Horizon-Avionics/Horizon-Mini/Software/src/sensors/ERRORCODES.md

ERROR 1 = Failed IMU i2c initialization
ERROR 2 = Faile IMU Reading
Error 3 = Failed BMU i2c initialization
Error 4 = Failed BMU reading
