Horizon-Avionics/Horizon-Mini/BOM.md

## PCB Components
| Name | Part # | Qty | Total Price |
| --- | --- | --- | --- |
| Buzzer | QMB-09B-03 | 3 | 0.3276 |
| 100nF | CC0603KRX7R9BB104 | 40 | 0.092 |
| 100nF |  |  |  |
| 100nF | CL05B104KO5NNNC | 22 | 0.0242 |
| 3.3nF | CL10B332KB8NNNC | 20 | 0.102 |
| 10uF | CL10A106KP8NNNC | 40 | 0.224 |
| 10uF |  |  |  |
| 4n7 | 0603B472K500NT | 20 | 0.054 |
| 22uF | CL10A226MQ8NRNC | 20 | 0.172 |
| 1uF | CL10A105KB8NNNC | 20 | 0.094 |
| 1uF |  |  |  |
| 2u2 | CL10A225KO8NNNC | 20 | 0.114 |
| 100u | CL31A107MQHNNNE | 6 | 0.3924 |
| SMLVN6RGB | SMLVN6RGB1U1 | 2 | 1.614 |
| PMEG6020ER | PMEG6020ER | 16 | 0.6752 |
| LED | KT-0603R | 20 | 0.112 |
| PRTR5V0U2X | PRTR5V0U2X | 6 | 0.237 |
| Conn_01x02_Pin | DB301V-3.5-2P-GN-S | 3 | 0.2706 |
| Micro_SD_Card_Det1 | DM3D-SF | 2 | 2.028 |
| USB_C_Receptacle_USB2.0_16P | GT-USB-7010ASV | 2. | 0.1572 |
| Conn_02x03_Counter_Clockwise | ZX-PZ2.54-2-3PZZ | 2 | 0.0624 |
| SLF7055T-6R8N2R8-3PF | SLF7055T-6R8N2R8-3PF | 2 | 0.5478 |
| BSS138 | BSS138 | 10.| 0.162 |
| DMG2301L | DMG2301L | 6 | 0.3378 |
| 2k2 | 0603WAF2201T5E | 40 | 0.04 |
| 2.2k |  |  |  |
| 10kΩ | 0402WGF1002TCE | 20 | 0.01 |
| 350k | AR03FTDX3503N | 20 | 0.156 |
| 100 | 0603WAF1000T5E | 20 | 0.02 |
| 430k | 0603WAF4303T5E | 20 | 0.022 |
| 100k | 0603WAF1003T5E | 40 | 0.04 |
| 10kΩ | 0603WAF1002T5E | 40 | 0.036 |
| 10k |  |  |  |
| 220 | 0603WAF2200T5E | 20 | 0.022 |
| 330 | 0603WAF3300T5E | 20 | 0.02 |
| 5k1 | 0603WAF5101T5E | 20 | 0.02 |
| 1.5k | 0603WAF1501T5E | 20 | 0.02 |
| TPS82130 | TPS82130SILR | 2 | 2.541 |
| TPS61092 | TPS61092RSAR | 2 | 4.731 |
| LTC4412xS6 | LTC4412IS6#TRMPBF | 2 | 5.496 |
| ATSAMD21G18A-A | ATSAMD21G18A-AU | 2 | 6.2 |
| NAND | W25Q128JVSIQ | 2 | 1.821 |
| LSM6DS3 | LSM6DS3TR-C | 2 | 2.091 |
| AP2112K-3.3 | AP2112K-3.3TRG1 | 5 | 0.4615 |
| LPS22HB | LPS22HBTR | 2 | 0.8505 |

---

## Extra Parts
| Comment | Part # | Qty | Total Price |
| --- | --- | --- | --- |
| LPS22HB | AliExpress | 2 | 4 |
| DAPLINK | AliExpress | 2 | 4 |
| Hot Air Gun | https://www.amazon.ca/TXINLEI-8858-Station-Soldering-Nozzles/dp/B09VXD8BTF | 1 | 35.44 |

---

## Totals
- **PCB total (with tax & shipping):** 41.06
- **LCSC Parts total (with tax & shipping):** 52.14
- **Other Items(with tax & shipping):** 43.44
- **Grand total:** $136.64
