Horizon-Avionics/Horizon-Mini/Hardware/.step

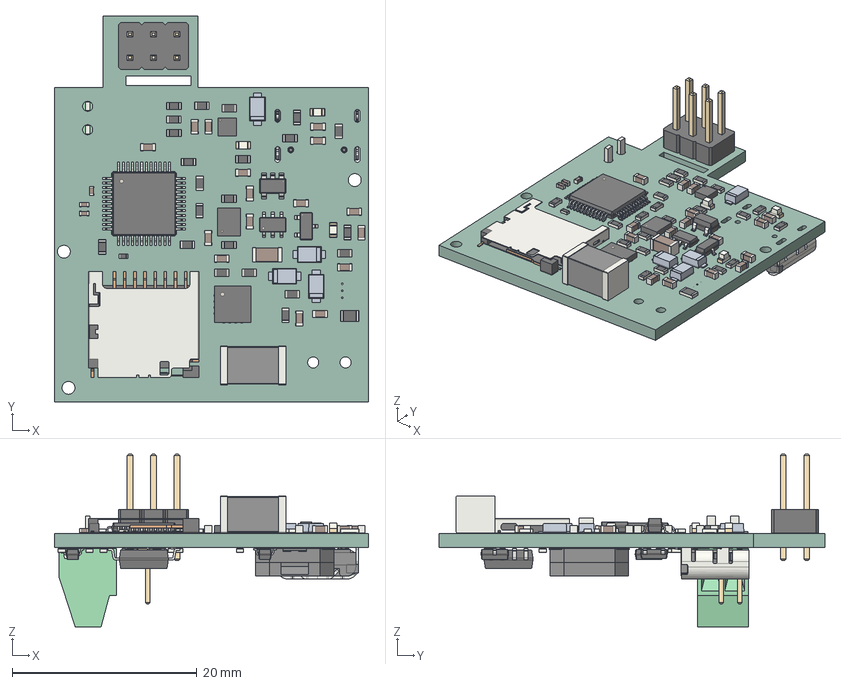
[picture p6: CAD file, 2025-12-22]
Hardware/.step
34.0 x 41.8 x 18.7 mm
R_0603_1608Metric x 30
SOT-23 x 3
C_0603_1608Metric x 16
.step 1.8.1 x 4
LED_0603_1608Metric x 4
TQFP-48_7x7mm_P0.5mm
PinHeader_2x03_P2.54mm_Vertical
microSD_HC_Hirose_DM3D-SF
SOT-23-5
R_0402_1005Metric
C_1206_3216Metric
L_2816_7142Metric
C_0402_1005Metric x 6
LGA-14_3x2.5mm_P0.5mm_LayoutBorder3x4y
ST_HLGA-10_2x2mm_P0.5mm_LayoutBorder3x2y
TSOT-23-6
Texas_RSA_VQFN-16-1EP_4x4mm_P0.65mm_EP2.7x2.7mm
R_0805_2012Metric
PinHeader_1x02_P2.00mm_Vertical_SMD_Pin1Left
TerminalBlock_Phoenix_MPT-0,5-2-2.54_1x02_P2.54mm_Horizontal
SOT-143
USB_C_Receptacle_GCT_USB4105-xx-A_16P_TopMnt_Horizontal
MLT-8530--3DModel-STEP-269445
Fuse_0603_1608Metric
SOIC-8_5.3x5.3mm_P1.27mm
horizon-mini_PCB
