Horizon-Avionics/Horizon-Mini/Hardware/horizon-mini.kicad_pcb

## KiCad design Hardware/horizon-mini.kicad_pcb (2026-02-26)

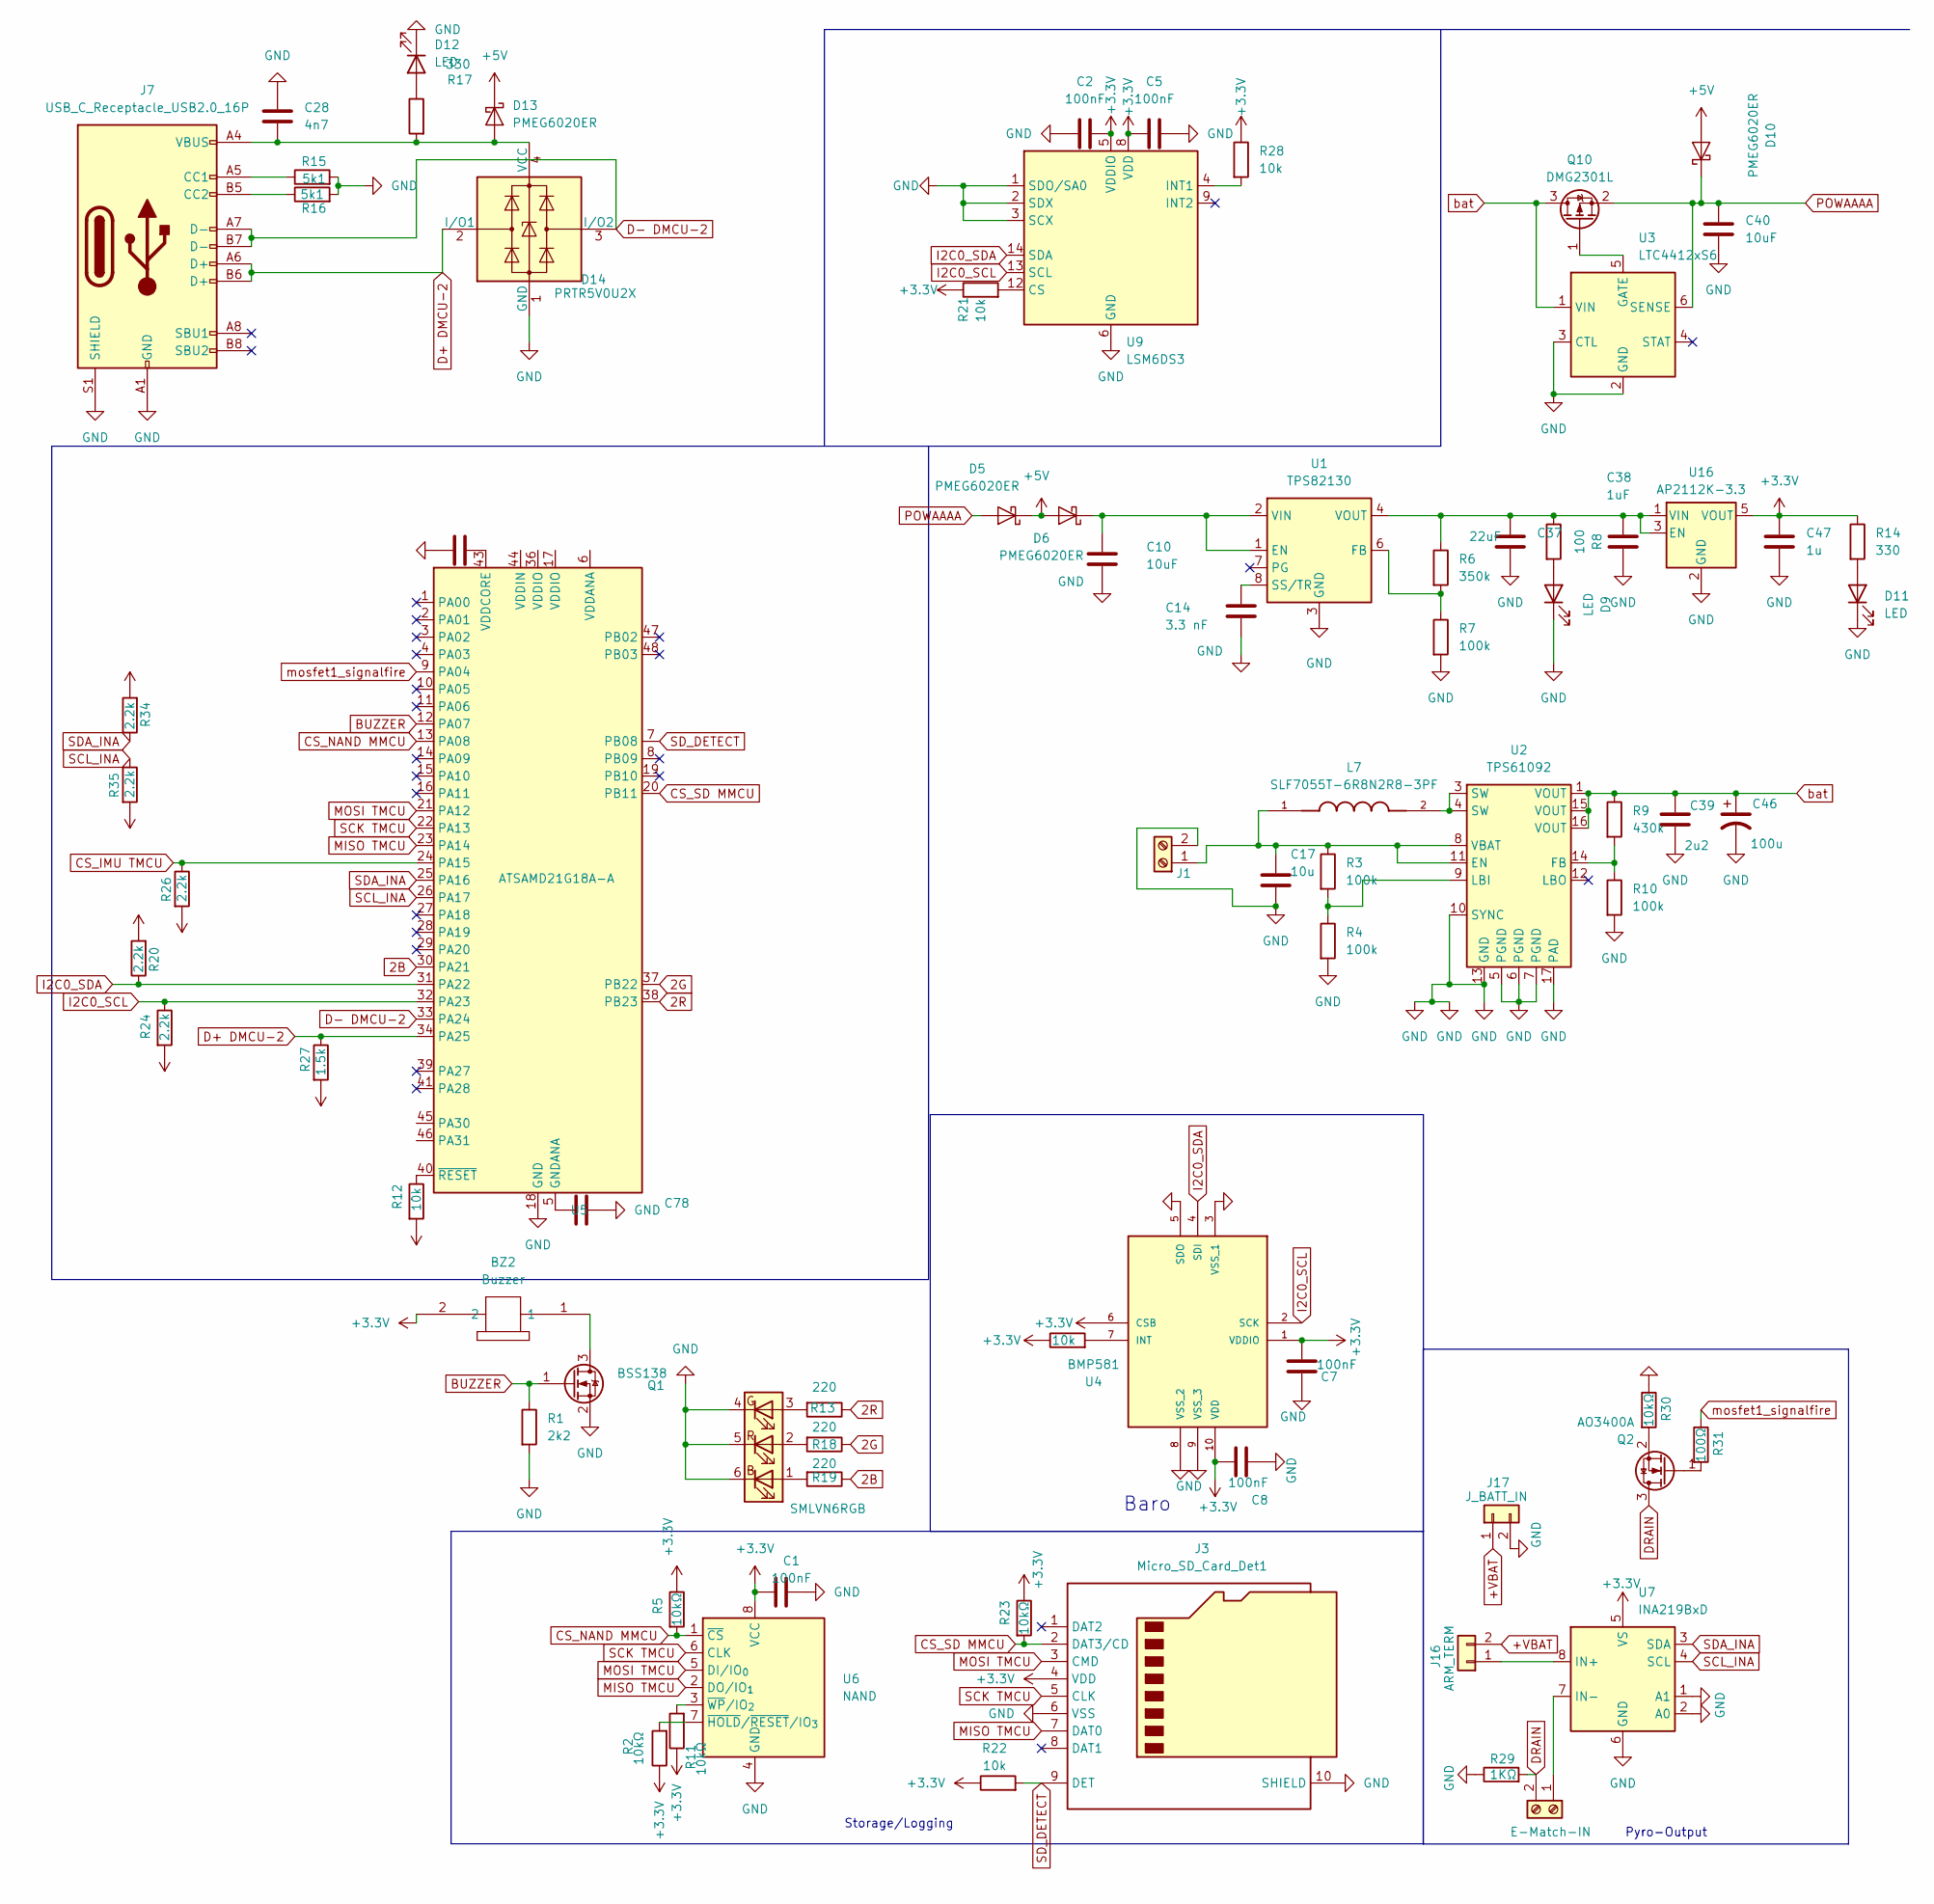
[picture p7: schematic horizon-mini.kicad_sch]

Parts:
BZ2: Buzzer; MLT-8530_JHE
C1, C2, C5, C7, C8, C78: 100nF; C_0402_1005Metric
C6: F1uF; C_0402_1005Metric
C10, C40: 10uF; C_0402_1005Metric
C14: 3.3 nF; C_0402_1005Metric
C17: 10u; C_0402_1005Metric
C28: 4n7; C_0402_1005Metric
C37: 22uF; C_0402_1005Metric
C38: 1uF; C_0402_1005Metric
C39: 2u2; C_0402_1005Metric
C46: 100u; C_0402_1005Metric
C47: 1u; C_0402_1005Metric
D1: SMLVN6RGB; LED_ROHM_SMLVN6
D5, D6, D10, D13: PMEG6020ER; Nexperia_CFP3_SOD-123W
D9, D11, D12: LED; LED_0603_1608Metric
D14: PRTR5V0U2X; SOT-143
J1: Screw_Terminal_01x02; TerminalBlock_Phoenix_MPT-0,5-2-2.54_1x02_P2.54mm_Horizontal
J3: Micro_SD_Card_Det1; microSD_HC_Hirose_DM3D-SF
J4: E-Match-IN; TerminalBlock_Phoenix_MPT-0,5-2-2.54_1x02_P2.54mm_Horizontal
J7: USB_C_Receptacle_USB2.0_16P; USB_C_Receptacle_GCT_USB4105-xx-A_16P_TopMnt_Horizontal
J16: ARM_TERM; PinHeader_1x02_P1.27mm_Vertical
J17: J_BATT_IN; PinHeader_1x02_P1.27mm_Vertical
L7: SLF7055T-6R8N2R8-3PF; L_7.3x7.3_H4.5; PARTREV N/A
Q1: BSS138; SOT-23
Q2: AO3400A; SOT-23
Q10: DMG2301L; SOT-23
R1: 2k2; R_0402_1005Metric
R2, R5, R11, R23, R30: 10kΩ; R_0402_1005Metric
R3, R4, R7, R10: 100k; R_0402_1005Metric
R6: 350k; R_0402_1005Metric
R8: 100; R_0402_1005Metric
R9: 430k; R_0402_1005Metric
R12, R21, R22, R28, R33: 10k; R_0402_1005Metric
R13, R18, R19: 220; R_0402_1005Metric
R14, R17: 330; R_0402_1005Metric
R15, R16: 5k1; R_0402_1005Metric
R20, R24, R26, R34, R35: 2.2k; R_0402_1005Metric
R27: 1.5k; R_0402_1005Metric
R29: 1KΩ; R_0402_1005Metric
R31: 100Ω; R_0402_1005Metric
U1: TPS82130; Texas_SIL0008D_MicroSiP-8-1EP_2.8x3mm_P0.65mm_EP1.1x1.9mm_T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
U2: TPS61092; Texas_RSA_VQFN-16-1EP_4x4mm_P0.65mm_EP2.7x2.7mm_ThermalVias
U3: LTC4412xS6; TSOT-23-6
U4: BMP581; Manufacturer_Part_Number BMP581
U5: ATSAMD21G18A-A; TQFP-48_7x7mm_P0.5mm
U6: NAND; SOIC-8_5.3x5.3mm_P1.27mm
U7: INA219BxD; SOIC-8_3.9x4.9mm_P1.27mm
U9: LSM6DS3; LGA-14_3x2.5mm_P0.5mm_LayoutBorder3x4y
U16: AP2112K-3.3; SOT-23-5

Connections:
2B: R19.1, U5.30 (PA21)
2G: R18.1, U5.37 (PB22)
2R: R13.1, U5.38 (PB23)
+3.3V: BZ2.2, C1.1, C2.2, C5.2, C7.2, C8.2, C47.1, J3.4 (VDD), R2.1, R5.1, R11.1, R12.2, R14.1, R20.2, R21.1, R22.1, R23.1, R24.2, R26.2, R27.2, R28.1, R33.1, R34.2, R35.2, U4.1 (VDDIO), U4.6 (CSB), U4.10 (VDD), U6.8 (VCC), U7.5 (VS), U9.5 (VDDIO), U9.8 (VDD), U16.5 (VOUT)
+5V: D5.1 (K), D6.2 (A), D10.2 (A), D13.1 (K)
+VBAT: J16.2, J17.1
BUZZER: Q1.1 (G), R1.1, U5.12 (PA07)
CS_IMU TMCU: R26.1, U5.24 (PA15)
CS_NAND MMCU: R5.2, U5.13 (PA08), U6.1 (~CS)
CS_SD MMCU: J3.2 (DAT3/CD), R23.2, U5.20 (PB11)
D+ DMCU-2: D14.2 (I/O1), J7.A6 (D+), J7.B6 (D+), R27.1, U5.34 (PA25)
D- DMCU-2: D14.3 (I/O2), J7.A7 (D-), J7.B7 (D-), U5.33 (PA24)
DRAIN: J4.2, Q2.3 (D), R29.2
GND: C1.2, C2.1, C5.1, C6.2, C7.1, C8.1, C10.2, C14.2, C17.2, C28.1, C37.2, C38.2, C39.2, C40.2, C46.2, C47.2, C78.1, D1.4 (GK), D1.5 (RK), D1.6 (BK), D9.1 (K), D11.1 (K), D12.1 (K), D14.1 (GND), J1.2, J3.6 (VSS), J3.10 (SHIELD), J7.A1 (GND), J7.A12 (GND), J7.B1 (GND), J7.B12 (GND), J7.S1 (SHIELD), J17.2, Q1.2 (S), R1.2, R4.2, R7.2, R10.2, R15.2, R16.2, R29.1, R30.1, U1.3 (GND), U1.9 (GND), U2.5 (PGND), U2.6 (PGND), U2.7 (PGND), U2.10 (SYNC), U2.13 (GND), U2.17 (PAD), U3.2 (GND), U3.3 (CTL), U4.3 (VSS_1), U4.5 (SDO), U4.8 (VSS_2), U4.9 (VSS_3), U5.18 (GND), U5.35 (GND), U5.42 (GND), U6.4 (GND), U7.1 (A1), U7.2 (A0), U7.6 (GND), U9.1 (SDO/SA0), U9.2 (SDX), U9.3 (SCX), U9.6 (GND), U9.7 (GND), U16.2 (GND); also elsewhere on the board
I2C0_SCL: R24.1, U4.2 (SCK), U5.32 (PA23), U9.13 (SCL)
I2C0_SDA: R20.1, U4.4 (SDI), U5.31 (PA22), U9.14 (SDA)
MISO TMCU: J3.7 (DAT0), U5.23 (PA14), U6.2 (DO/IO_{1})
MOSI TMCU: J3.3 (CMD), U5.21 (PA12), U6.5 (DI/IO_{0})
unnamed: D1.1 (BA), R19.2
unnamed: D1.3 (GA), R13.2
unnamed: D1.2 (RA), R18.2
unnamed: C10.1, D6.1 (K), U1.1 (EN), U1.2 (VIN)
unnamed: D9.2 (A), R8.2
unnamed: D11.2 (A), R14.2
unnamed: D12.2 (A), R17.1
unnamed 25: C28.2, D13.2 (A), D14.4 (VCC), J7.A4 (VBUS), J7.A9 (VBUS), J7.B4 (VBUS), J7.B9 (VBUS), R17.2; also elsewhere on the board
unnamed: C17.1, J1.1, L7.1, R3.1, U2.8 (VBAT), U2.11 (EN)
unnamed: J4.1, U7.7 (IN-)
unnamed: J7.A5 (CC1), R15.1
unnamed: J7.B5 (CC2), R16.1
unnamed: J16.1, U7.8 (IN+)
unnamed: L7.2, U2.3 (SW), U2.4 (SW)
unnamed: BZ2.1, Q1.3 (D)
unnamed: Q2.1 (G), R31.2
unnamed: Q2.2 (S), R30.2
unnamed: Q10.1 (G), U3.5 (GATE)
unnamed: R6.2, R7.1, U1.6 (FB)
unnamed: C14.1, U1.8 (SS/TR)
unnamed: R9.2, R10.1, U2.14 (FB)
unnamed: R3.2, R4.1, U2.9 (LBI)
unnamed: R33.2, U4.7 (INT)
unnamed: C78.2, U5.5 (GNDANA)
unnamed: C6.1, U5.43 (VDDCORE)
unnamed: R12.1, U5.40 (~RESET)
unnamed: R2.2, U6.7 (~HOLD/~RESET/IO_{3})
unnamed: R11.2, U6.3 (~WP/IO_{2})
unnamed: R21.2, U9.12 (CS)
unnamed: R28.2, U9.4 (INT1)
unnamed: C37.1, C38.1, R6.1, R8.1, U1.4 (VOUT), U1.5 (VOUT), U16.1 (VIN), U16.3 (EN)
POWAAAA: C40.1, D5.2 (A), D10.1 (K), Q10.2 (S), U3.6 (SENSE)
SCK TMCU: J3.5 (CLK), U5.22 (PA13), U6.6 (CLK)
SCL_INA: R35.1, U5.26 (PA17)
SDA_INA: R34.1, U5.25 (PA16)
SD_DETECT: J3.9 (DET), R22.2, U5.7 (PB08)
bat: C39.1, C46.1, Q10.3 (D), R9.1, U2.1 (VOUT), U2.15 (VOUT), U2.16 (VOUT), U3.1 (VIN)
mosfet1_signalfire: R31.1, U5.9 (PA04)

Notes on the sheet:
Pyro-Output
Storage/Logging
Baro

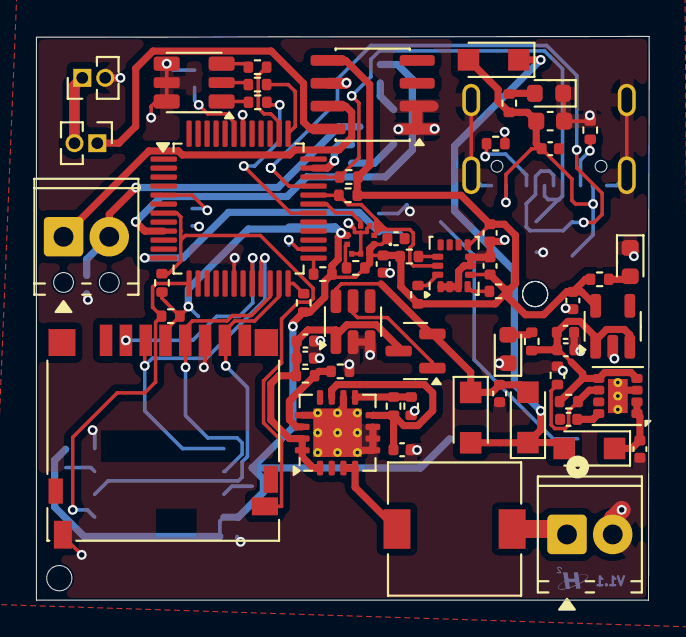
[picture p8: board horizon-mini.kicad_pcb from above]

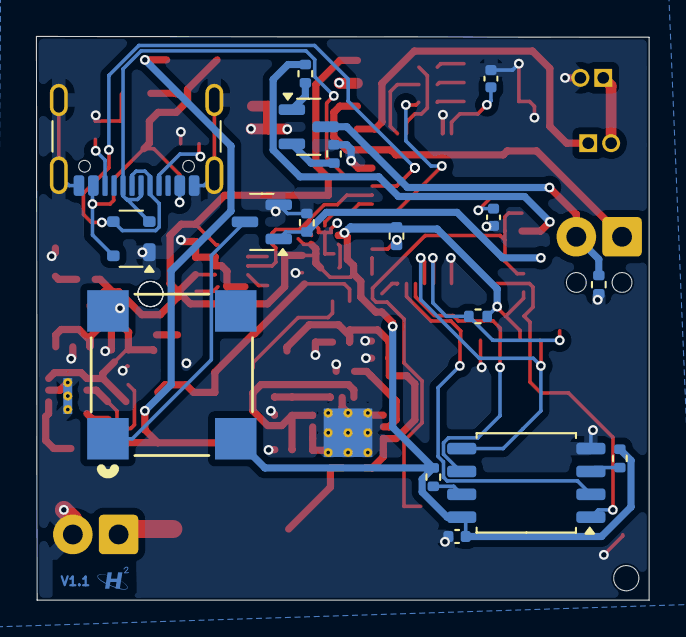
[picture p9: board horizon-mini.kicad_pcb from below]

Board: 2 copper layers, 34.0 x 31.3 mm, 79 parts (17 on the bottom side), 55 nets.

Other parts of the board:
C29: 100n; C_0603_1608Metric

Their connections:
GND: C29.1; also elsewhere on the board
unnamed 25: C29.2; also elsewhere on the board
