Horizon-Avionics/Horizon-Mini/(commit log)

2025-06-29 added kicad project
    [horizon-mini.kicad_pcb, horizon-mini.kicad_sch]
2025-06-29 added main board files
    [horizon.kicad_pcb, horizon.kicad_sch, power.kicad_sch, sensor.kicad_sch, usb.kicad_sch]
2025-06-29 Deleted unneeded chips and changes sensors from spi to i2c
    [horizon-mini.kicad_pcb, horizon.kicad_pcb, horizon.kicad_sch, power.kicad_sch, sensor.kicad_sch, usb.kicad_sch]
2025-06-29 moved files to folders
    [horizon-mini.kicad_pcb, horizon-mini.kicad_sch, horizon.kicad_sch]
2025-06-29 deleted unneeded files
    [horizon-mini.kicad_sch, horizon.kicad_pcb, horizon.kicad_sch, power.kicad_sch, sensor.kicad_sch, usb.kicad_sch]
2025-06-29 deleted MORE files
    [horizon-mini.kicad_sch]
2025-06-30 starting first routing
    [horizon-mini.kicad_pcb]
2025-06-30 idk more changes
    [horizon-mini.kicad_sch]
2025-06-30 traces v1
2025-06-30 routes v2!!!!
    [horizon-mini.kicad_pcb]
2025-07-08 finish v2 traces
    [horizon-mini.kicad_pcb, horizon-mini.kicad_sch]
2025-07-08 Re-started routing, like 3/4 done parts placement
    [horizon-mini.kicad_pcb, horizon-mini.kicad_sch]
2025-07-08 parts placement is done
    [horizon-mini.kicad_pcb, horizon-mini.kicad_sch]
2025-07-08 board routing is finally done... DRC errors look fake to me, but need to be double checked
2025-07-09 uuuh, fixed shematic and re-did most of the routing for the new MCU :(
    [horizon-mini.kicad_pcb, horizon-mini.kicad_sch]
2025-07-09 Revert "Merge branch 'main' of https://github.com/Horizon-Avionics/Horizon-Mini"
    This reverts commit 9a022c3cd95984122db224f561db0d5bee869fb2, reversing
    changes made to 44f91161868ebb609577ad71ea77d3c9bc8dd4bf.
    [horizon-mini.kicad_sch]
2025-07-09 Wiring take 2 is done- just a few DRC errors left
    [horizon-mini.kicad_pcb, horizon-mini.kicad_sch]
2025-07-09 deleted unneded files and added software folder
    [horizon-mini.kicad_pcb, horizon-mini.kicad_sch]
2025-07-09 fixed software and added platformio
    [main.cpp]
2025-07-09 added imu library and basic readings
2025-07-09 added speed and velocity formulas
2025-07-09 forgot to push...
    [bom.csv, designators.csv, horizon-mini.kicad_sch, positions.csv]
2025-07-09 led is started(need mucho mas trabajo)
2025-07-10 finished led logic shit
2025-07-10 Finally done... DRC look good, PCB is good, and schematic looks good!
    [bom.csv, designators.csv, horizon-mini.kicad_pcb, horizon-mini.kicad_sch, positions.csv]
2025-07-10 now final ;)... Needed to switch the 100uF to 0206, since 0603's for that just don't exist!
    [bom.csv, horizon-mini.kicad_pcb, positions.csv]
2025-07-10 final take 2 ;). Now no JLC DFM errors either!
    [horizon-mini.kicad_pcb]
2025-07-11 the final final one
    [bom.csv, horizon-mini.kicad_pcb, horizon-mini.kicad_sch, positions.csv]
2025-07-11 Update and rename BOM.csv to BOM.md
    [BOM.csv]
2025-07-11 i̶t̶'s̶ a̶l̶l̶ d̶o̶w̶n̶ h̶i̶l̶l̶ f̶r̶o̶m̶ h̶e̶r̶e̶ f̶r̶i̶e̶n̶d̶s̶
    [bom.csv, horizon-mini.kicad_pcb, positions.csv]
2025-07-14 getting somewhere take 2
    [horizon-mini.kicad_pcb]
2025-07-14 DRC and some PCB routing stuff
    [horizon-mini.kicad_pcb]
2025-07-14 routing v2 should be done
    [horizon-mini.kicad_pcb]
2025-07-14 please liam fix decop caps
    [horizon-mini.kicad_pcb]
2025-07-14 fixed decop caps schematic and routes (plz check my work scooter)
    [horizon-mini.kicad_pcb]
2025-07-14 maybe good?
    [horizon-mini.kicad_pcb, horizon-mini.kicad_sch]
2025-07-14 ready for submission v2!
    [horizon-mini.kicad_pcb, horizon-mini.kicad_sch]
2025-07-14 Revert "Merge branch 'main' of https://github.com/Horizon-Avionics/Horizon-Mini"
    This reverts commit 679f00b043b1fbfec2143f9512c96a76483b1c63, reversing
    changes made to 3d15d739e12ed0ad8f757afd069957ffb8171449.
    [horizon-mini.kicad_sch]
2025-07-14 forgot to push
    [horizon-mini.kicad_pcb]
2025-07-14 submission time!
    [horizon-mini.kicad_pcb]
2025-07-15 the board has been stitched!
    [horizon-mini.kicad_pcb]
2025-07-15 fixed schematic
    i hate github
    [horizon-mini.kicad_sch]
2025-07-16 add prod files
    [bom.csv, designators.csv, horizon-mini.kicad_pcb, positions.csv]
2025-07-16 what happened to the schemtaic lol?
    [horizon-mini.kicad_sch]
2025-07-17 wooooah, found an error.. all good now!
    [horizon-mini.kicad_pcb, positions.csv]
2025-07-18 adding pyro schematic stuff
    [horizon-mini.kicad_sch]
2025-07-18 5.08mm terminal
    [horizon-mini.kicad_pcb]
2025-07-22 Revert "Merge branch 'main' of https://github.com/Horizon-Avionics/Horizon-Mini"
    This reverts commit 832f827b9a251a47b3d6c5f971ce72bc000230f5, reversing
    changes made to 952e8a21e36a298005532ab4306c205f1d35711e.
    [bom.csv, designators.csv, horizon-mini.kicad_pcb, horizon-mini.kicad_sch, positions.csv]
2025-07-22 what the github commits did I just figure out how to do
    [horizon-mini.kicad_pcb, horizon-mini.kicad_sch]
2025-07-22 uuuh, starting buzzer wiring while I'm waiting for max's amazing footprint ;)
    [horizon-mini.kicad_pcb, horizon-mini.kicad_sch]
2025-07-24 please look it over, I'm finished with it
    [bom.csv, designators.csv, horizon-mini.kicad_pcb, horizon-mini.kicad_sch, positions.csv]
2025-07-25 forgot to push from last night. Very small silscreen changes and stuff
    [horizon-mini.kicad_pcb, horizon-mini.kicad_sch]
2025-09-25 @mpkendall review before ordering pplllease. I fixed the data lines.
    [horizon-mini.kicad_pcb]
2025-10-27 @mpkendall please review before ordering.
    [bom.csv, designators.csv, horizon-mini.kicad_pcb, positions.csv]
2025-11-07 fixed the data lines. @mpkendall please review so we don't need x3 :)
    no gerber's were exported for this.
    [horizon-mini.kicad_pcb, horizon-mini.kicad_sch]
2025-11-09 regen gerber baby files
    [horizon-mini-B_Cu.gbr, horizon-mini-B_Mask.gbr, horizon-mini-B_Paste.gbr, horizon-mini-B_Silkscreen.gbr, horizon-mini-Edge_Cuts.gbr, horizon-mini-F_Cu.gbr, horizon-mini-F_Mask.gbr, horizon-mini-F_Paste.gbr]
2025-11-09 @starry-liam please re-gen gerbers: fixed schematic parity
    [horizon-mini.kicad_pcb, horizon-mini.kicad_sch]
2025-11-09 bye bye old gerbers
    [horizon-mini-B_Cu.gbr, horizon-mini-B_Mask.gbr, horizon-mini-B_Paste.gbr, horizon-mini-B_Silkscreen.gbr, horizon-mini-Edge_Cuts.gbr, horizon-mini-F_Cu.gbr, horizon-mini-F_Mask.gbr, horizon-mini-F_Paste.gbr]
2025-11-09 final gerbers???
2025-11-11 started nand, added variant for RGB pins
    [feather_m0.cfg]
2025-11-11 ill redo LED later it was cuasing trouble
2025-12-22 added resistors in series with D+/D- and flipped inductor to other side
    [.step]
2026-02-01 Changed the Baro to the higher accuracy one, and worked on re-doing the pyro-output... almost done it!
    [horizon-mini.kicad_pcb, horizon-mini.kicad_sch]
2026-02-26 ah yes, I love that I forgot to push lol. Fixed pyro + rerouted to save space.
    [horizon-mini.kicad_pcb, horizon-mini.kicad_sch]
2026-02-26 added prod files
    [bom.csv, designators.csv, positions.csv]
